beeb/nts-player/docs/README.md

# Datasheets

| Part | Use | Document |
| --- | --- | --- |
| PCM5122 | DAC | [TI SLAS763](https://www.ti.com/lit/ds/symlink/pcm5122.pdf) |
| TPS22918 | LED ring power | [TI SLVSD76](https://www.ti.com/lit/ds/symlink/tps22918.pdf) |
| SN74AHCT1G125 | LED level shifter | [TI SCLS378](https://www.ti.com/lit/ds/symlink/sn74ahct1g125.pdf) |
| LM66100 | Ideal diode | [TI SLVSEZ8](https://www.ti.com/lit/ds/symlink/lm66100.pdf) |
| PEC11R-4120F-S0018 | Encoder | [Bourns PEC11R](https://www.bourns.com/docs/product-datasheets/pec11r.pdf) |
| RCJ-2123 | RCA jack | [Same Sky RCJ-21](https://www.sameskydevices.com/product/resource/rcj-21.pdf) |
| SJ1-3523N | 3.5 mm jack | [Same Sky SJ1-352XN](https://www.sameskydevices.com/product/resource/sj1-352xn.pdf) |
| ESP32-S3-DEV-KIT-N8R8 | Devkit | [Waveshare wiki](https://www.waveshare.com/wiki/ESP32-S3-DEV-KIT-N8R8) |
| ESP32-S3-DEV-KIT-N8R8 | Devkit schematic  | [Waveshare schematic](https://files.waveshare.com/wiki/ESP32-S3-DEV-KIT-N8R8/ESP32-S3-DEV-KIT-N8R8-schematic.pdf) |
| Adafruit PCM5122 | Reference design  | [Adafruit downloads](https://learn.adafruit.com/adafruit-pcm5122-i2s-dac/downloads) |

## Devkit Pinout

[`esp32-s3-dev-kit-pinout.pdf`](./esp32-s3-dev-kit-pinout.pdf): "ESP32-S3-DEV-KIT-NxR8 Pinout", Rev. 0.1, by Vishnu
Mohanan, [CIRCUITSTATE Electronics](https://www.circuitstate.com/). It is licensed under
[CC BY 4.0](https://creativecommons.org/licenses/by/4.0/) and is not modified. The licenses of this repository do not
apply to it.
