beeb/nts-player/enclosure/logos.step

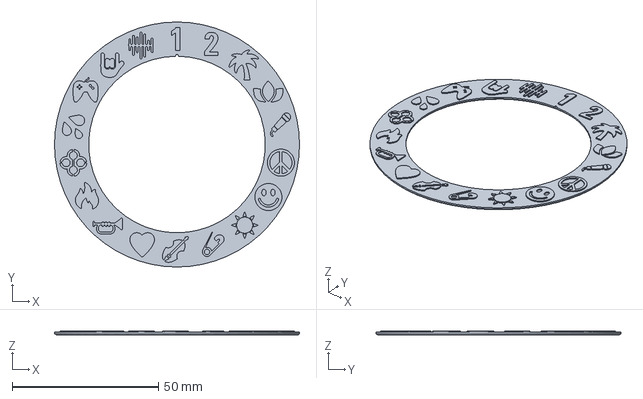
[picture p1: CAD file, 2026-11-12]
enclosure/logos.step
83.7 x 83.7 x 1.36 mm
