beeb/nts-player/enclosure/top_case.step

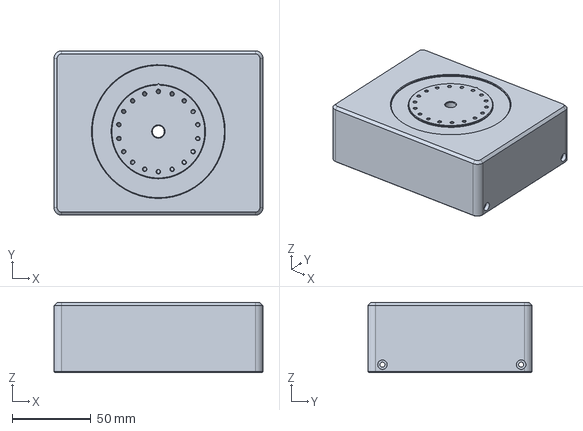
[picture p2: CAD file, 2026-11-12]
enclosure/top_case.step
132.8 x 104.4 x 44.5 mm
