beeb/nts-player/enclosure/bottom_case.step

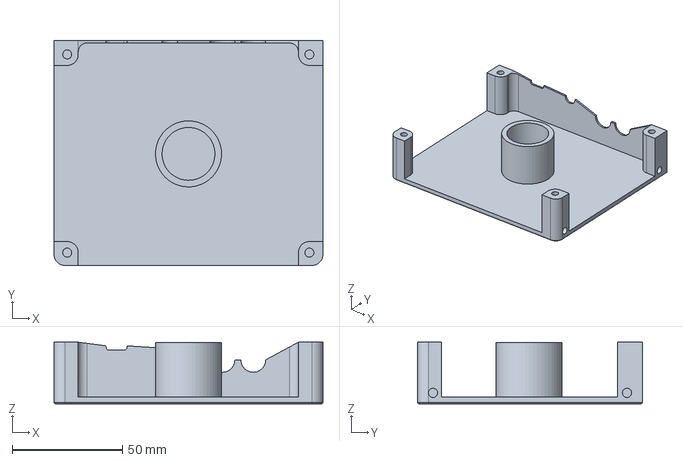
[picture p3: CAD file, 2026-11-12]
enclosure/bottom_case.step
122.2 x 102.1 x 28.0 mm
