beeb/nts-player/(list of files, cad)

Other CAD files:
enclosure/bottom_case.stl
enclosure/logos.stl
enclosure/top_case.stl
