beeb/nts-player/kicad/nts_player/nts_player.kicad_pcb

## KiCad design kicad/nts_player/nts_player.kicad_pcb (2026-10-24)

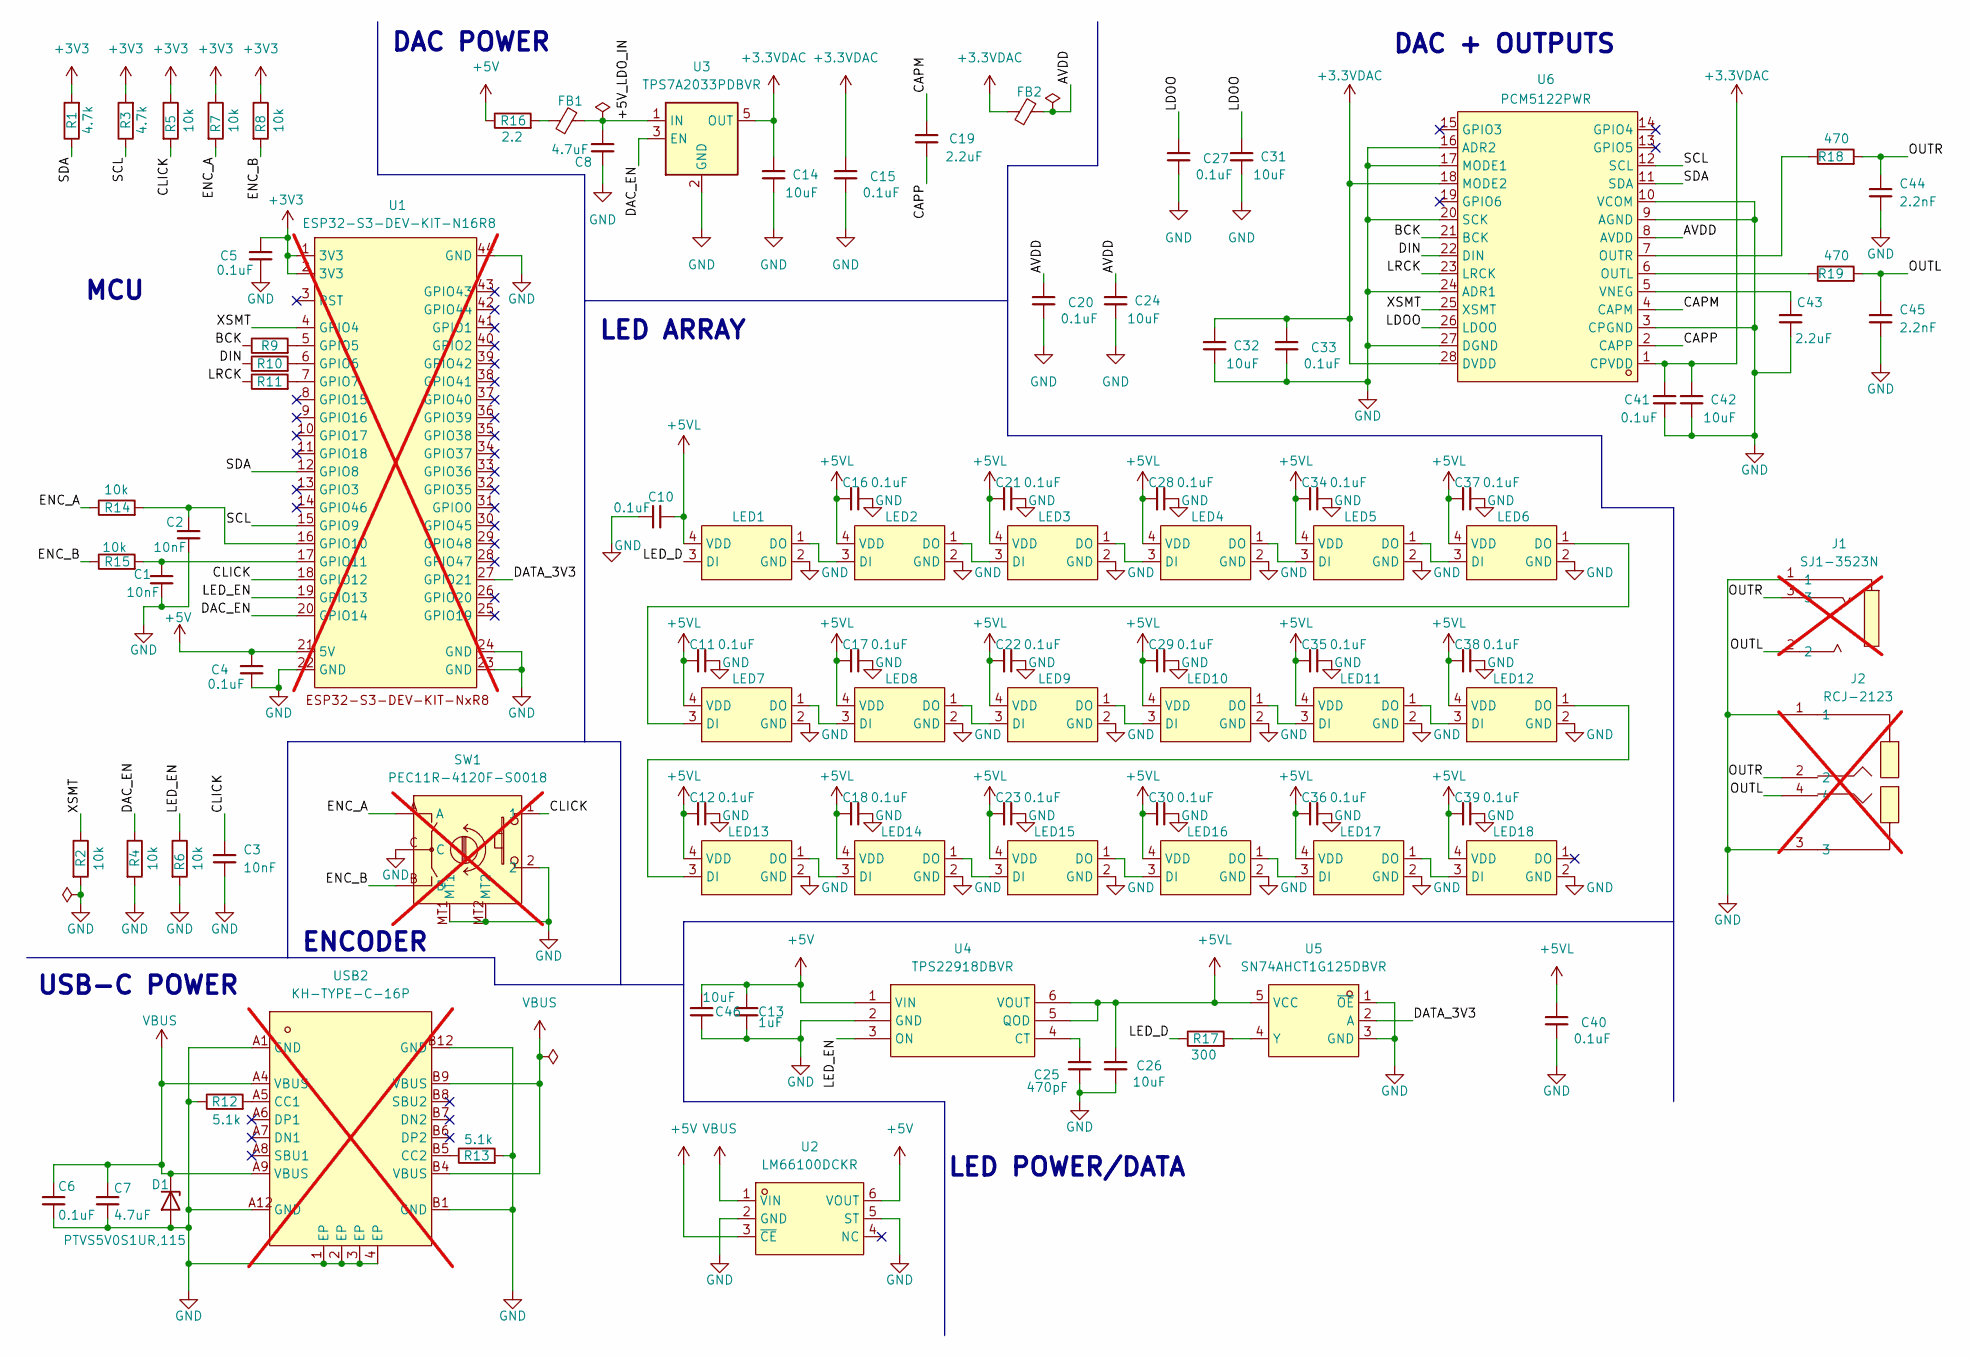
[picture p4: schematic nts_player.kicad_sch, NTS Player]

Parts:
C1, C2, C3: 10nF; C0603; MPN 0603B103K500NT; LCSC Part C57112
C4, C5, C6, C10, C11, C12, C15, C16, C17, C18, C20, C21, C22, C23, C27, C28, C29, C30, C33, C34, C35, C36, C37, C38, C39, C40, C41: 0.1uF; C0603; MPN CC0603KRX7R9BB104; LCSC Part C14663
C7, C8: 4.7uF; C0603; MPN CL10A475KO8NNNC; LCSC Part C19666
C13: 1uF; C0603; MPN CL10A105KB8NNNC; LCSC Part C15849
C14, C24, C26, C31, C32, C42, C46: 10uF; C1206; MPN CL31A106KBHNNNE; LCSC Part C13585
C19, C43: 2.2uF; C1206; MPN CL31B225KBHNNNE; LCSC Part C50254
C25: 470pF; C0805; MPN 0805B471K500NT; LCSC Part C1743
C44, C45: 2.2nF; C0805; MPN CL21C222JBFNNNE; LCSC Part C28260
D1: PTVS5V0S1UR,115; SOD-123_L2.8-W1.8-LS3.7-RD; MPN PTVS5V0S1UR,115; LCSC Part C478011
FB1, FB2: GZ1608D601TF; L0603; MPN GZ1608D601TF; LCSC Part C1002
J1: SJ1-3523N; AUDIO-TH_SJ1-3523N; MPN SJ1-3523N; LCSC Part C20182914; not fitted
J2: RCJ-2123; CONN-TH_RCJ-2123; MPN RCJ-2123; LCSC Part C4991847; not fitted
LED1, LED2, LED3, LED4, LED5, LED6, LED7, LED8, LED9, LED10, LED11, LED12, LED13, LED14, LED15, LED16, LED17, LED18: WS2812B-2020-V6; WS2815B-2020-V6; MPN WS2812B-2020-V6; LCSC Part C52917434
R1, R3: 4.7k; R0603; MPN 0603WAF4701T5E; LCSC Part C23162
R2, R4, R5, R6, R7, R8, R14, R15: 10k; R0603; MPN 0603WAF1002T5E; LCSC Part C25804
R9, R10, R11: 33; R0603; MPN 0603WAF330JT5E; LCSC Part C23140
R12, R13: 5.1k; R0603; MPN 0603WAF5101T5E; LCSC Part C23186
R16: 2.2; R0603; MPN 0603WAF220KT5E; LCSC Part C22939
R17: 300; R0603; MPN 0603WAF3000T5E; LCSC Part C23025
R18, R19: 470; R0805; MPN 0805W8F4700T5E; LCSC Part C17710
SW1: PEC11R-4120F-S0018; SW-TH_PEC11R-4XXXF-SXXXX; MPN PEC11R-4120F-S0018; LCSC Part C22402546; not fitted
U1: ESP32-S3-DEV-KIT-N16R8; ESP32-S3-DEV-KIT-NXR8; not fitted
U2: LM66100DCKR; SC-70-6_L2.0-W1.3-P0.65-LS2.1-BL; MPN LM66100DCKR; LCSC Part C2869734
U3: TPS7A2033PDBVR; SOT-23-5; MPN TPS7A2033PDBVR; LCSC Part C2862740
U4: TPS22918DBVR; SOT-23-6_L2.9-W1.6-P0.95-LS2.8-BR; MPN TPS22918DBVR; LCSC Part C131941
U5: SN74AHCT1G125DBVR; SOT-23-5_L3.0-W1.7-P0.95-LS2.8-BR; MPN SN74AHCT1G125DBVR; LCSC Part C7484
U6: PCM5122PWR; TSSOP-28_L9.8-W6.6-P0.65-BL; MPN PCM5122PWR; LCSC Part C962071
USB2: KH-TYPE-C-16P; USB-C-SMD_KH-TYPE-C-16P; MPN KH-TYPE-C-16P; LCSC Part C709357; not fitted

Connections:
+3.3VDAC: C14.2, C15.2, C32.2, C33.2, C41.2, C42.2, FB2.1, U3.5 (OUT), U6.1 (CPVDD), U6.18 (MODE2), U6.28 (DVDD)
+3V3: C5.2, R1.2, R3.2, R5.1, R7.1, R8.1, U1.1 (3V3), U1.2 (3V3)
+5V: C4.2, C13.1, C46.2, R16.1, U1.21 (5V), U2.3 (~CE), U2.6 (VOUT), U4.1 (VIN)
+5VL: C10.1, C11.2, C12.2, C16.2, C17.2, C18.2, C21.2, C22.2, C23.2, C26.2, C28.2, C29.2, C30.2, C34.2, C35.2, C36.2, C37.2, C38.2, C39.2, C40.2, LED1.4 (VDD), LED2.4 (VDD), LED3.4 (VDD), LED4.4 (VDD), LED5.4 (VDD), LED6.4 (VDD), LED7.4 (VDD), LED8.4 (VDD), LED9.4 (VDD), LED10.4 (VDD), LED11.4 (VDD), LED12.4 (VDD), LED13.4 (VDD), LED14.4 (VDD), LED15.4 (VDD), LED16.4 (VDD), LED17.4 (VDD), LED18.4 (VDD), U4.5 (QOD), U4.6 (VOUT), U5.5 (VCC)
/+5V_LDO_IN: C8.1, FB1.2, U3.1 (IN)
/AVDD: C20.2, C24.2, FB2.2, U6.8 (AVDD)
/BCK: R9.1, U6.21 (BCK)
/CAPM: C19.1, U6.4 (CAPM)
/CAPP: C19.2, U6.2 (CAPP)
/CLICK: C3.1, R5.2, SW1.1, U1.18 (GPIO12)
/DAC_EN: R4.1, U1.20 (GPIO14), U3.3 (EN)
/DATA_3V3: U1.27 (GPIO21), U5.2 (A)
/DIN: R10.1, U6.22 (DIN)
/ENC_A: R7.2, R14.1, SW1.A
/ENC_B: R8.2, R15.1, SW1.B
/LDOO: C27.2, C31.2, U6.26 (LDOO)
/LED_D: LED1.3 (DI), R17.1
/LED_EN: R6.1, U1.19 (GPIO13), U4.3 (ON)
/LRCK: R11.1, U6.23 (LRCK)
/OUTL: C45.1, J1.2, J2.4, R19.2
/OUTR: C44.1, J1.3, J2.2, R18.2
/SCL: R3.1, U1.15 (GPIO9), U6.12 (SCL)
/SDA: R1.1, U1.12 (GPIO8), U6.11 (SDA)
/XSMT: R2.1, U1.4 (GPIO4), U6.25 (XSMT)
GND: C1.2, C2.2, C3.2, C4.1, C5.1, C6.1, C7.2, C8.2, C10.2, C11.1, C12.1, C13.2, C14.1, C15.1, C16.1, C17.1, C18.1, C20.1, C21.1, C22.1, C23.1, C24.1, C25.2, C26.1, C27.1, C28.1, C29.1, C30.1, C31.1, C32.1, C33.1, C34.1, C35.1, C36.1, C37.1, C38.1, C39.1, C40.1, C41.1, C42.1, C43.2, C44.2, C45.2, C46.1, D1.2 (A), J1.1, J2.1, J2.3, LED1.2 (GND), LED2.2 (GND), LED3.2 (GND), LED4.2 (GND), LED5.2 (GND), LED6.2 (GND), LED7.2 (GND), LED8.2 (GND), LED9.2 (GND), LED10.2 (GND), LED11.2 (GND), LED12.2 (GND), LED13.2 (GND), LED14.2 (GND), LED15.2 (GND), LED16.2 (GND), LED17.2 (GND), LED18.2 (GND), R2.2, R4.2, R6.2, R12.1, R13.2, SW1.2, SW1.C, SW1.MT1, SW1.MT2, U1.22 (GND), U1.23 (GND), U1.24 (GND), U1.44 (GND), U2.2 (GND), U2.5 (ST), U3.2 (GND), U4.2 (GND), U5.1 (~OE), U5.3 (GND), U6.3 (CPGND), U6.9 (AGND), U6.10 (VCOM), U6.16 (ADR2), U6.17 (MODE1), U6.20 (SCK), U6.24 (ADR1), U6.27 (DGND), USB2.1 (EP), USB2.2 (EP), USB2.3 (EP), USB2.4 (EP), USB2.A1 (GND), USB2.A12 (GND), USB2.B1 (GND), USB2.B12 (GND); also elsewhere on the board
unnamed: FB1.1, R16.2
unnamed: LED1.1 (DO), LED2.3 (DI)
unnamed: LED2.1 (DO), LED3.3 (DI)
unnamed: LED3.1 (DO), LED4.3 (DI)
unnamed: LED4.1 (DO), LED5.3 (DI)
unnamed: LED5.1 (DO), LED6.3 (DI)
unnamed: LED6.1 (DO), LED7.3 (DI)
unnamed: LED7.1 (DO), LED8.3 (DI)
unnamed: LED8.1 (DO), LED9.3 (DI)
unnamed: LED9.1 (DO), LED10.3 (DI)
unnamed: LED10.1 (DO), LED11.3 (DI)
unnamed: LED11.1 (DO), LED12.3 (DI)
unnamed: LED12.1 (DO), LED13.3 (DI)
unnamed: LED13.1 (DO), LED14.3 (DI)
unnamed: LED14.1 (DO), LED15.3 (DI)
unnamed: LED15.1 (DO), LED16.3 (DI)
unnamed: LED16.1 (DO), LED17.3 (DI)
unnamed: LED17.1 (DO), LED18.3 (DI)
unnamed: R9.2, U1.5 (GPIO5)
unnamed: R10.2, U1.6 (GPIO6)
unnamed: R11.2, U1.7 (GPIO7)
unnamed: C2.1, R14.2, U1.16 (GPIO10)
unnamed: C1.1, R15.2, U1.17 (GPIO11)
unnamed: C25.1, U4.4 (CT)
unnamed: R17.2, U5.4 (Y)
unnamed: R19.1, U6.6 (OUTL)
unnamed: R18.1, U6.7 (OUTR)
unnamed: C43.1, U6.5 (VNEG)
unnamed: R12.2, USB2.A5 (CC1)
unnamed: R13.1, USB2.B5 (CC2)
VBUS: C6.2, C7.1, D1.1 (K), U2.1 (VIN), USB2.A4 (VBUS), USB2.A9 (VBUS), USB2.B4 (VBUS), USB2.B9 (VBUS)

Notes on the sheet:
ENCODER
DAC POWER
LED POWER/DATA
MCU
DAC + OUTPUTS
USB-C POWER
LED ARRAY

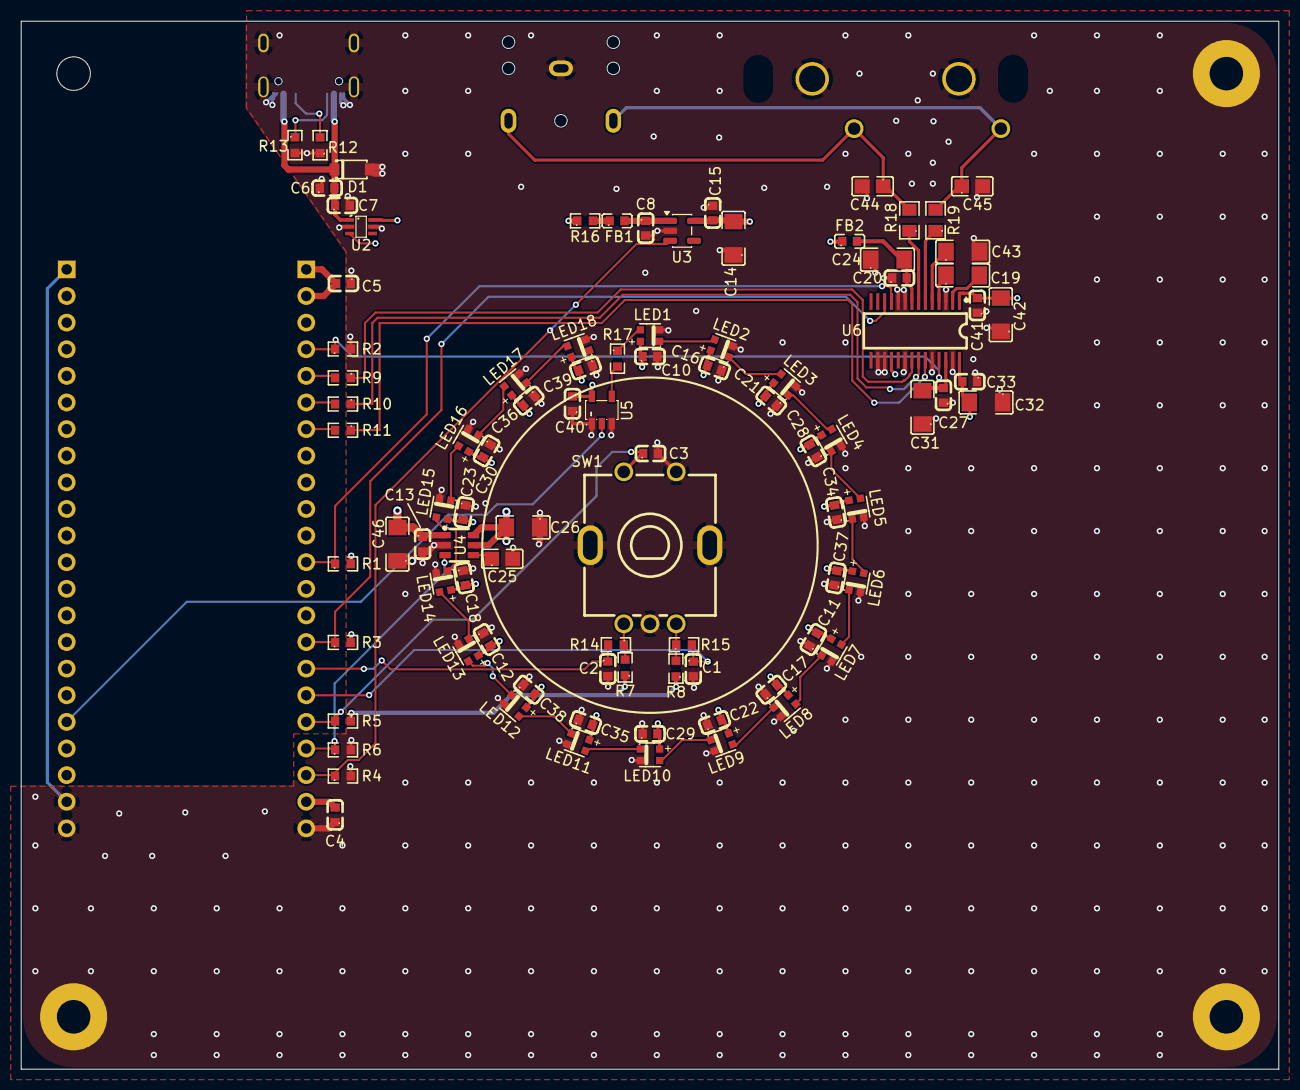
[picture p5: board nts_player.kicad_pcb from above]

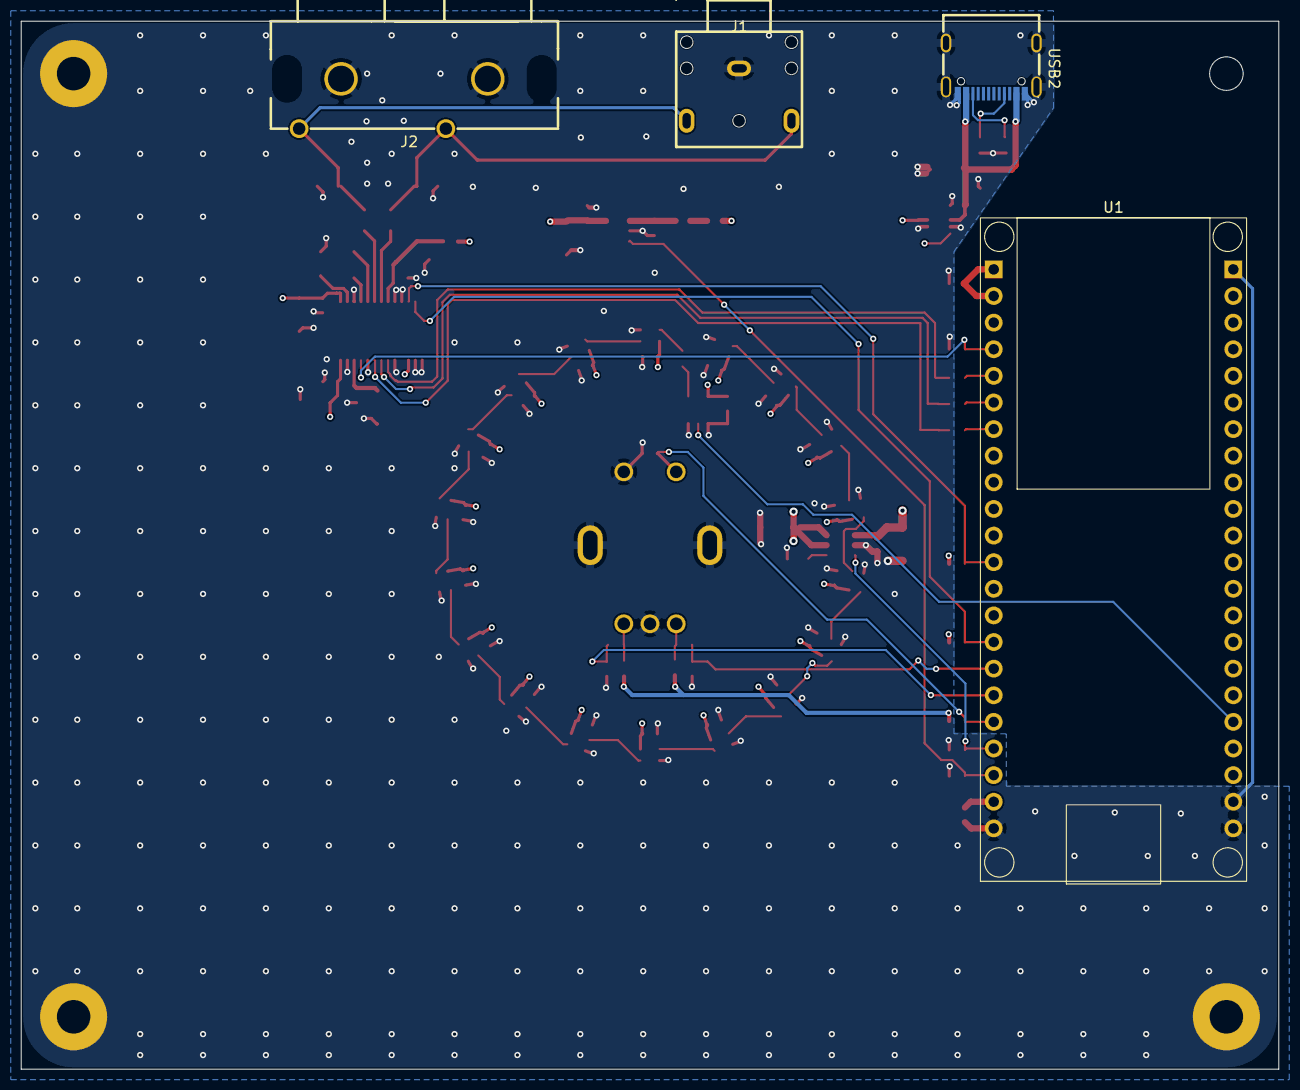
[picture p6: board nts_player.kicad_pcb from below]

Board: 4 copper layers, 120.0 x 100.0 mm, 99 parts (4 on the bottom side), 56 nets.

Other parts of the board:
H1: MountingHole_3.2mm_M3
H2, H3, H4: MountingHole_3.2mm_M3_Pad

Their connections:
GND: H2.1, H3.1, H4.1; also elsewhere on the board
