beeb/nts-player/firmware/src/main.rs

use std::{
    sync::{Arc, Mutex, mpsc},
    thread,
    time::Duration,
};

use anyhow::Result;
use esp_idf_svc::{
    eventloop::EspSystemEventLoop,
    hal::{peripherals::Peripherals, reset::restart},
    nvs::EspDefaultNvsPartition,
    wifi::{BlockingWifi, EspWifi},
};

use crate::{
    api::{Api, Snapshot},
    audio::Player,
    buffer::RingBuffer,
    dac::{Dac, DacPins, I2sPins},
    input::{InputPins, Ui},
    led::{Color, Led, Ring},
    ota::Ota,
    settings::Settings,
    status::{State, Status},
    stream::{Stream, Tuner},
    wifi::Credentials,
};

mod api;
mod audio;
mod buffer;
mod dac;
mod input;
mod led;
mod ota;
mod portal;
mod prelude;
mod settings;
mod status;
mod stream;
mod wifi;

/// Name and version in the image header, the update page checks them.
#[expect(unexpected_cfgs)]
mod app_desc {
    esp_idf_svc::sys::esp_app_desc!();
}

const CONNECT_ATTEMPTS: usize = 3;
const PORTAL_TIMEOUT: Duration = Duration::from_mins(5);
const WIFI_CHECK_INTERVAL: Duration = Duration::from_secs(5);

/// About 5 s of audio at 256 kbps.
const BUFFER_SIZE: usize = 160 * 1024;

fn main() {
    // It is necessary to call this function once. Otherwise, some patches to the runtime
    // implemented by esp-idf-sys might not link properly. See https://github.com/esp-rs/esp-idf-template/issues/71
    esp_idf_svc::sys::link_patches();

    // Bind the log crate to the ESP Logging facilities
    esp_idf_svc::log::EspLogger::initialize_default();

    let mut led = None;
    let status = Arc::new(Status::default());
    if let Err(e) = run(&mut led, &status) {
        log::error!("{e:?}");
        status.set(State::Fatal);
        if let Some(led) = &led {
            led.set(Color::DBG_RED).ok();
        }
        thread::sleep(Duration::from_secs(5));
        restart();
    }
}

/// Run the app, storing the LED in `led` so that `main` can still use it on error.
#[expect(
    clippy::too_many_lines,
    reason = "the startup sequence reads best in one place"
)]
fn run(led: &mut Option<Arc<Led>>, status: &Arc<Status>) -> Result<()> {
    let peripherals = Peripherals::take()?;
    let led = led.insert(Arc::new(Led::new(peripherals.pins.gpio38)?));
    let nvs = EspDefaultNvsPartition::take()?;
    let settings = Settings::load(nvs.clone())?;
    let tuner = Arc::new(Tuner::new(settings.station));
    let buffer = Arc::new(RingBuffer::new(BUFFER_SIZE));
    let dac = Arc::new(Dac::new(
        DacPins {
            en: peripherals.pins.gpio14.degrade_output(),
            xsmt: peripherals.pins.gpio4.degrade_output(),
            i2c: peripherals.i2c0,
            sda: peripherals.pins.gpio8.degrade_input_output(),
            scl: peripherals.pins.gpio9.degrade_input_output(),
            i2s: I2sPins {
                i2s: peripherals.i2s0,
                bck: peripherals.pins.gpio5.degrade_input_output(),
                din: peripherals.pins.gpio6.degrade_output(),
                lrck: peripherals.pins.gpio7.degrade_input_output(),
            },
        },
        settings.volume,
    )?);
    let snapshot = Arc::new(Mutex::new(Snapshot::new(settings)));
    let (commands_tx, commands_rx) = mpsc::channel();
    Ui::spawn(
        InputPins {
            enc_a: peripherals.pins.gpio10.degrade_input(),
            enc_b: peripherals.pins.gpio11.degrade_input(),
            push: peripherals.pins.gpio12.degrade_input(),
            boot: peripherals.pins.gpio0.degrade_input(),
        },
        led.clone(),
        Ring::new(peripherals.pins.gpio21, peripherals.pins.gpio13)?,
        tuner.clone(),
        buffer.clone(),
        dac.clone(),
        status.clone(),
        settings,
        snapshot.clone(),
        commands_rx,
        nvs.clone(),
    )?;
    let sysloop = EspSystemEventLoop::take()?;
    let mut wifi = BlockingWifi::wrap(
        EspWifi::new(peripherals.modem, sysloop.clone(), Some(nvs.clone()))?,
        sysloop,
    )?;

    let Some(mut creds) = Credentials::load(nvs.clone())? else {
        log::info!("no wifi credentials saved");
        led.set(Color::DBG_BLUE)?;
        status.set(State::Portal);
        return portal::run(wifi, nvs, None); // stay on portal forever
    };
    led.set(Color::DBG_YELLOW)?;
    let connected = (1..=CONNECT_ATTEMPTS).any(|attempt| {
        creds
            .connect(&mut wifi)
            .inspect_err(|e| {
                log::warn!(
                    "connection attempt {attempt} to {} failed: {e:?}",
                    creds.ssid
                );
            })
            .is_ok()
    });
    if !connected {
        // connecting with saved credentials failed, let's show the portal
        // again for a little bit before we retry
        led.set(Color::DBG_BLUE)?;
        status.set(State::Portal);
        return portal::run(wifi, nvs, Some(PORTAL_TIMEOUT));
    }
    led.set(Color::DBG_GREEN)?;
    status.set(State::Online);
    log::info!(
        "connected to {}, ip: {}",
        creds.ssid,
        wifi.wifi().sta_netif().get_ip_info()?.ip
    );
    if let Err(e) = creds.save_channel(nvs.clone(), &wifi) {
        log::warn!("could not save wifi channel: {e:?}");
    }

    Stream::spawn(tuner, buffer.clone(), status.clone(), nvs)?;
    Player::spawn(buffer, dac)?;
    if let Err(e) = Api::spawn(wifi.wifi().sta_netif(), snapshot, commands_tx.clone()) {
        log::warn!("could not start the API, playing anyway: {e:?}");
    }
    // keep the server alive in the loop below
    let _ota = Ota::start(commands_tx)
        .inspect_err(|e| log::warn!("could not start the update page, playing anyway: {e:?}"));
    // keep `wifi` alive and reconnect it when the link drops
    loop {
        thread::sleep(WIFI_CHECK_INTERVAL);
        if wifi.is_connected()? {
            continue;
        }
        log::warn!("wifi down, reconnecting");
        status.set(State::Connecting);
        if let Err(e) = creds.connect(&mut wifi) {
            log::warn!("wifi reconnect failed: {e:?}");
            // the router may have moved to another channel
            creds.channel = None;
        } else {
            log::info!("wifi reconnected");
            status.set(State::Online);
        }
    }
}
