beeb/nts-player/firmware/src/input.rs

use std::{
    sync::Arc,
    thread,
    time::{Duration, Instant},
};

use anyhow::Result;
use esp_idf_svc::{
    hal::{
        delay::FreeRtos,
        gpio::{AnyInputPin, Input, Pin, PinDriver, Pull},
        pcnt::{
            PcntUnitDriver,
            config::{
                ChannelConfig, ChannelEdgeAction, ChannelLevelAction, GlitchFilterConfig,
                UnitConfig,
            },
        },
        reset::restart,
    },
    nvs::EspDefaultNvsPartition,
    sys::{
        esp, esp_deep_sleep_start, esp_sleep_enable_ext0_wakeup, esp_wifi_stop, nvs_flash_erase,
        rtc_gpio_pullup_en,
    },
};

use crate::{
    buffer::RingBuffer,
    dac::Dac,
    led::{Color, Led, RING_LEDS, Ring},
    settings::{Settings, Volume},
    status::{State, Status},
    stream::{STATION_COUNT, Tuner},
};

/// Stack size of the input thread, NVS writes need more than the 4 KB default.
const STACK_SIZE: usize = 8 * 1024;

/// Hold time for putting the device to sleep.
const LONG_PRESS: Duration = Duration::from_millis(700);

/// Hold time of the boot button for erasing NVS and restarting.
const RESET_PRESS: Duration = Duration::from_secs(5);

/// Color of the onboard LED blink while the boot button is held, then solid once NVS is erased.
const RESET_WARNING: Color = Color::DBG_RED;

/// Time after the last step before a change is applied and saved.
const SETTLE: Duration = Duration::from_millis(400);

/// Go back from volume to station mode automatically after this duration without input.
const VOLUME_TIMEOUT: Duration = Duration::from_secs(5);

/// Time without input before dimming the ring.
const IDLE_TIMEOUT: Duration = Duration::from_secs(10);

/// Ring level when idle, from 0 to 1.
const IDLE_LEVEL: f32 = 0.4;

/// Number of [`POLL_DELAY_MS`] duration ticks for the ring fade before sleep.
const FADE_TICKS: u16 = 30;

/// Polling interval for the inputs, in milliseconds.
const POLL_DELAY_MS: u32 = 10;

/// Quadrature edges per encoder detent (18 pulses and 18 detents per turn).
const EDGES_PER_DETENT: i32 = 4;

/// Glitch filter for the encoder signals, at most 12.7 us on the ESP32-S3.
const ENCODER_GLITCH: Duration = Duration::from_micros(10);

/// Number of [`POLL_DELAY_MS`] duration ticks for the switch debounce.
const DEBOUNCE_TICKS: u32 = 3;

/// Period of the station LED pulse while buffering.
const PULSE_PERIOD: Duration = Duration::from_millis(1500);

/// Period of the ring pulse while the setup portal runs.
const PORTAL_PERIOD: Duration = Duration::from_secs(3);

/// Lowest pulse level, as a fraction of the full color.
const PULSE_MIN: f32 = 0.2;

/// Period of the blink on a fatal error or a stream failure.
const BLINK_PERIOD: Duration = Duration::from_secs(1);

/// Duration of the spinning animation while connecting to wifi.
const SPIN_PERIOD: Duration = Duration::from_secs(1);

/// The input pins, all active low.
pub struct InputPins {
    /// Encoder channel A.
    pub enc_a: AnyInputPin<'static>,

    /// Encoder channel B.
    pub enc_b: AnyInputPin<'static>,

    /// Push button for mode switch and deep sleep/wake up.
    pub push: AnyInputPin<'static>,

    /// Boot button of the devkit, long-press to erase NVS and restart.
    pub boot: AnyInputPin<'static>,
}

/// The input and UI thread state.
pub struct Ui {
    encoder: Encoder,
    push: Switch,
    boot: Switch,
    led: Arc<Led>,
    ring: Ring,
    tuner: Arc<Tuner>,
    buffer: Arc<RingBuffer>,
    dac: Arc<Dac>,
    status: Arc<Status>,
    nvs: EspDefaultNvsPartition,
    settings: Settings,
    mode: Mode,
    /// The scene during the last draw.
    scene: Scene,
    /// Start of the current scene, for its animation.
    scene_start: Instant,
    /// Start of the current push.
    ///
    /// The first push (waking up the device) does not count, so it's still `None`. Also `None` when the button is
    /// not pressed.
    pushed_at: Option<Instant>,
    /// Start of the current boot button press.
    boot_pushed_at: Option<Instant>,
    /// Time of the last station or volume change that is not applied yet.
    changed_at: Option<Instant>,
    /// Time of the last input (press or turn).
    input_at: Instant,
    /// Scale of the ring level during the fade before sleep, from 0 to 1.
    fade: f32,
}

impl Ui {
    /// Start the input thread.
    #[expect(
        clippy::too_many_arguments,
        reason = "each argument is a distinct shared handle"
    )]
    pub fn spawn(
        pins: InputPins,
        led: Arc<Led>,
        ring: Ring,
        tuner: Arc<Tuner>,
        buffer: Arc<RingBuffer>,
        dac: Arc<Dac>,
        status: Arc<Status>,
        settings: Settings,
        nvs: EspDefaultNvsPartition,
    ) -> Result<()> {
        let ui = Self {
            encoder: Encoder::new(pins.enc_a, pins.enc_b)?,
            push: Switch::new(pins.push)?,
            boot: Switch::new(pins.boot)?,
            led,
            ring,
            tuner,
            buffer,
            dac,
            status,
            nvs,
            settings,
            mode: Mode::Station,
            scene: Scene::Station,
            scene_start: Instant::now(),
            pushed_at: None,
            boot_pushed_at: None,
            changed_at: None,
            input_at: Instant::now(),
            fade: 1.0,
        };
        thread::Builder::new()
            .stack_size(STACK_SIZE)
            .spawn(move || {
                if let Err(e) = ui.run() {
                    log::error!("input thread: {e:?}");
                }
            })?;
        Ok(())
    }

    fn run(mut self) -> Result<()> {
        loop {
            FreeRtos::delay_ms(POLL_DELAY_MS);
            if let Some(step) = self.encoder.poll()? {
                self.step(step);
            }
            let push = self.push.poll();
            if push.is_some() {
                self.input_at = Instant::now();
            }
            match push {
                Some(true) => self.pushed_at = Some(Instant::now()),
                // only handle the change if we have a `pushed_at` and clear the timer
                Some(false) if self.pushed_at.take().is_some() => {
                    self.mode = self.mode.toggle();
                    log::info!("mode: {:?}", self.mode);
                }
                _ => {}
            }
            if matches!(self.mode, Mode::Volume) && self.input_at.elapsed() >= VOLUME_TIMEOUT {
                // switch back to station mode after inactivity
                self.mode = Mode::Station;
                log::info!("mode: {:?} (timeout)", self.mode);
            }
            if self.pushed_at.is_some_and(|t| t.elapsed() >= LONG_PRESS) {
                return self.sleep();
            }
            if let Some(pressed) = self.boot.poll() {
                self.boot_pushed_at = pressed.then(Instant::now);
                if !pressed && let Err(e) = self.led.restore() {
                    log::warn!("could not restore the LED: {e:?}");
                }
            }
            if let Some(t) = self.boot_pushed_at.map(|t| t.elapsed()) {
                if t >= RESET_PRESS {
                    return self.reset();
                }
                // warn that holding longer erases everything
                let color = if blink(t) { RESET_WARNING } else { Color::OFF };
                if let Err(e) = self.led.show(color) {
                    log::warn!("could not update the LED: {e:?}");
                }
            }
            if self.changed_at.is_some_and(|t| t.elapsed() >= SETTLE) {
                self.changed_at = None;
                self.commit();
            }
            self.draw();
        }
    }

    /// Move the pending station or the volume by one step.
    fn step(&mut self, step: Step) {
        let s = &mut self.settings;
        match self.mode {
            Mode::Station => {
                let n = STATION_COUNT;
                s.station = match step {
                    Step::Left => s.station.checked_sub(1).unwrap_or(n - 1),
                    Step::Right => (s.station + 1) % n,
                };
                log::info!("station {} (pending)", s.station);
            }
            Mode::Volume => {
                s.volume = match step {
                    Step::Left => s.volume.down(),
                    Step::Right => s.volume.up(),
                };
                log::info!("volume {}/{}", s.volume.get(), Volume::MAX.get());
                // the settle delay is only for saving
                if let Err(e) = self.dac.set_volume(s.volume) {
                    log::warn!("could not set the volume: {e:?}");
                }
            }
        }
        self.changed_at = Some(Instant::now());
        self.input_at = Instant::now();
    }

    /// Apply the pending station and save the settings.
    fn commit(&self) {
        if self.tuner.get() != self.settings.station {
            log::info!("tuning to station {}", self.settings.station);
            if let Err(e) = self.dac.mute() {
                log::warn!("could not mute: {e:?}");
            }
            self.buffer.clear();
            self.tuner.set(self.settings.station);
        }
        if let Err(e) = self.settings.save(self.nvs.clone()) {
            log::warn!("could not save settings: {e:?}");
        }
    }

    /// Draw the current scene on the ring.
    fn draw(&mut self) {
        let idle = self.input_at.elapsed() >= IDLE_TIMEOUT;
        let level = if idle { IDLE_LEVEL } else { 1.0 };
        self.ring.set_level(level * self.fade);
        let scene = self.scene();
        // restart the animation on each change
        if scene != self.scene {
            self.scene = scene;
            self.scene_start = Instant::now();
        }
        let t = self.scene_start.elapsed();
        let station = self.settings.station;
        let color = Color::station(station);
        let res = match scene {
            Scene::Fatal if blink(t) => self.ring.all(Color::ERROR),
            Scene::Fatal => self.ring.all(Color::OFF),
            Scene::Portal => self.ring.all(Color::WIFI.scale(wave(t, PORTAL_PERIOD))),
            Scene::Connecting => self.ring.dot(spin(t), Color::WIFI),
            Scene::Stalled if blink(t) => self.ring.dot(station, color),
            Scene::Stalled => self.ring.dot(station, Color::OFF),
            Scene::Buffering => self.ring.dot(station, color.scale(wave(t, PULSE_PERIOD))),
            Scene::Station => self.ring.dot(station, color),
            Scene::Volume => self.ring.volume(self.settings.volume),
        };
        if let Err(e) = res {
            log::warn!("could not update LED ring: {e:?}");
        }
    }

    fn scene(&self) -> Scene {
        match self.status.get() {
            State::Fatal => Scene::Fatal,
            State::Portal => Scene::Portal,
            State::Connecting => Scene::Connecting,
            State::Online => match self.mode {
                Mode::Station if self.status.is_stalled() => Scene::Stalled,
                Mode::Station if self.buffer.is_filling() => Scene::Buffering,
                Mode::Station => Scene::Station,
                Mode::Volume => Scene::Volume,
            },
        }
    }

    /// Turn everything off, wait for the button release and enter deep sleep.
    fn sleep(&mut self) -> Result<()> {
        log::info!("long press, going to sleep");
        self.dac.power_down()?;
        // turn the LEDs off to indicate the press was long enough
        self.led.set(Color::OFF)?;
        for tick in (0..FADE_TICKS).rev() {
            self.fade = f32::from(tick) / f32::from(FADE_TICKS);
            self.draw();
            FreeRtos::delay_ms(POLL_DELAY_MS);
        }
        self.ring.shutdown()?;
        while self.push.pin.is_low() {
            FreeRtos::delay_ms(POLL_DELAY_MS);
        }
        // a bounce at sleep start would wake the device right away
        FreeRtos::delay_ms(DEBOUNCE_TICKS * POLL_DELAY_MS);
        unsafe { esp_wifi_stop() };
        let pin = self.push.pin.pin().into();
        esp!(unsafe { rtc_gpio_pullup_en(pin) })?;
        esp!(unsafe { esp_sleep_enable_ext0_wakeup(pin, 0) })?;
        unsafe { esp_deep_sleep_start() }
    }

    /// Erase the whole NVS partition, wait for the boot button release and restart.
    fn reset(&mut self) -> Result<()> {
        log::warn!("boot button held, erasing NVS");
        self.ring.set_level(1.0);
        self.ring.all(Color::ERROR)?;
        self.led.show(RESET_WARNING)?;
        esp!(unsafe { nvs_flash_erase() })?;
        // the boot button is a strapping pin, don't restart while it's low
        while self.boot.pin.is_low() {
            FreeRtos::delay_ms(POLL_DELAY_MS);
        }
        restart();
    }
}

/// Encoder input mode.
#[derive(Clone, Copy, Debug)]
enum Mode {
    /// Change the station
    Station,

    /// Adjust the volume.
    Volume,
}

impl Mode {
    fn toggle(self) -> Self {
        match self {
            Self::Station => Self::Volume,
            Self::Volume => Self::Station,
        }
    }
}

/// What the ring shows.
#[derive(Clone, Copy, PartialEq, Eq)]
enum Scene {
    Fatal,
    Portal,
    Connecting,
    Stalled,
    Buffering,
    Station,
    Volume,
}

/// One encoder detent.
#[derive(Clone, Copy)]
enum Step {
    Left,
    Right,
}

/// A quadrature encoder decoded by the PCNT (pulse counter) peripheral.
///
/// Edges are counted in hardware to avoid losing steps between polls.
struct Encoder {
    unit: PcntUnitDriver<'static>,
    /// Count at the last emitted step.
    pos: i32,
}

impl Encoder {
    fn new(a: AnyInputPin<'static>, b: AnyInputPin<'static>) -> Result<Self> {
        let limit = i32::from(i16::MAX);
        let mut unit = PcntUnitDriver::new(&UnitConfig {
            low_limit: -limit,
            high_limit: limit,
            accum_count: true,
            ..Default::default()
        })?;
        unit.set_glitch_filter(Some(&GlitchFilterConfig {
            max_glitch: ENCODER_GLITCH,
            ..Default::default()
        }))?;
        // each pin is the edge input of one channel and the level input of the other
        let (a2, b2) = unsafe { (AnyInputPin::steal(a.pin()), AnyInputPin::steal(b.pin())) };
        unit.add_channel(Some(a), Some(b), &ChannelConfig::default())?
            .set_edge_action(ChannelEdgeAction::Decrease, ChannelEdgeAction::Increase)?
            .set_level_action(ChannelLevelAction::Keep, ChannelLevelAction::Inverse)?;
        unit.add_channel(Some(b2), Some(a2), &ChannelConfig::default())?
            .set_edge_action(ChannelEdgeAction::Increase, ChannelEdgeAction::Decrease)?
            .set_level_action(ChannelLevelAction::Keep, ChannelLevelAction::Inverse)?;
        unit.enable()?;
        unit.add_watch_points_and_clear([-limit, limit])?;
        unit.start()?;
        Ok(Self { unit, pos: 0 })
    }

    /// Read the counter.
    ///
    /// Returns one step once the count moved a full detent away from the last step.
    fn poll(&mut self) -> Result<Option<Step>> {
        let delta = self.unit.get_count()? - self.pos;
        if delta >= EDGES_PER_DETENT {
            self.pos += EDGES_PER_DETENT;
            Ok(Some(Step::Right))
        } else if delta <= -EDGES_PER_DETENT {
            self.pos -= EDGES_PER_DETENT;
            Ok(Some(Step::Left))
        } else {
            Ok(None)
        }
    }
}

/// A debounced active-low switch, sampled on each poll.
struct Switch {
    pin: PinDriver<'static, Input>,
    pressed: bool,
    /// Number of polls reading the opposite of `pressed`, used for debouncing.
    count: u32,
}

impl Switch {
    fn new(pin: AnyInputPin<'static>) -> Result<Self> {
        let pin = PinDriver::input(pin, Pull::Up)?;
        Ok(Self {
            pressed: pin.is_low(),
            pin,
            count: 0,
        })
    }

    /// Sample the pin.
    ///
    /// Returns the new state once a change exceeds the debounce time.
    fn poll(&mut self) -> Option<bool> {
        if self.pin.is_low() == self.pressed {
            self.count = 0;
            return None;
        }
        self.count = self.count.saturating_add(1);
        if self.count < DEBOUNCE_TICKS {
            return None;
        }
        self.count = 0;
        self.pressed = !self.pressed;
        Some(self.pressed)
    }
}

/// Pulse level for [`Color::scale`] at `t`, a triangle wave from 1 down to [`PULSE_MIN`] and back.
fn wave(t: Duration, period: Duration) -> f32 {
    let phase = (t.as_secs_f32() / period.as_secs_f32()).fract();
    // 0 at the middle of the period, 1 at both ends
    let tri = (phase - 0.5).abs() * 2.0;
    PULSE_MIN + tri * (1.0 - PULSE_MIN)
}

/// Whether the blink is on at `t`.
fn blink(t: Duration) -> bool {
    let period = BLINK_PERIOD.as_millis();
    t.as_millis() % period < period / 2
}

/// LED index of the spinning dot at `t`.
fn spin(t: Duration) -> u8 {
    let period = SPIN_PERIOD.as_millis();
    let i = t.as_millis() % period * u128::from(RING_LEDS) / period;
    u8::try_from(i).unwrap_or(0)
}
