beeb/nts-player/firmware/src/led.rs

use std::sync::Mutex;

use anyhow::Result;
use esp_idf_svc::hal::{
    delay::FreeRtos,
    gpio::{Output, OutputPin, PinDriver},
    rmt::config::{MemoryAccess, TxChannelConfig},
    units::Hertz,
};
use ws2812_esp32_rmt_driver::Ws2812Esp32RmtDriver;

use crate::{prelude::OrPanic, settings::Volume, stream::LIVE_STATIONS};

/// Time for the ring's power rail to rise before sending data, in milliseconds.
///
/// This is 2 ticks at 100 Hz, because a 1 tick delay can end right away.
const RAIL_RISE_MS: u32 = 20;

/// Number of LEDs on the ring.
pub const RING_LEDS: u8 = 18;

/// Index of the bottom LED, where the volume bar starts.
const VOLUME_START: u8 = RING_LEDS / 2;

/// Level of the bottom LED at volume 0, as a fraction of the volume color.
const VOLUME_ZERO: f32 = 0.5;

/// Byte value of a full color channel on the ring.
const BRIGHTNESS: f32 = 16.0;

/// Byte value of a full color channel on the onboard LED, which is very bright.
const DBG_BRIGHTNESS: f32 = 1.0;

/// Color of an RGB LED, with channels from 0 to 1.
#[derive(Clone, Copy)]
pub struct Color {
    pub r: f32,
    pub g: f32,
    pub b: f32,
}

impl Color {
    pub const OFF: Self = Self::rgb(0.0, 0.0, 0.0);
    pub const DBG_RED: Self = Self::rgb(1.0, 0.0, 0.0);
    pub const DBG_YELLOW: Self = Self::rgb(1.0, 1.0, 0.0);
    pub const DBG_GREEN: Self = Self::rgb(0.0, 1.0, 0.0);
    pub const DBG_BLUE: Self = Self::rgb(0.0, 0.0, 1.0);
    pub const LIVE: Self = Self::rgb(0.7, 0.7, 0.7);
    pub const MIXTAPE: Self = Self::rgb(1.0, 0.0, 0.0);
    pub const VOLUME: Self = Self::rgb(0.8, 0.41, 0.12);
    pub const WIFI: Self = Self::rgb(0.25, 0.0, 1.0);
    pub const ERROR: Self = Self::rgb(1.0, 0.0, 0.0);

    pub const fn rgb(r: f32, g: f32, b: f32) -> Self {
        Self { r, g, b }
    }

    /// Color of a station's LED, white for the live channels and red for the mixtapes.
    pub fn station(index: u8) -> Self {
        if index < LIVE_STATIONS {
            Self::LIVE
        } else {
            Self::MIXTAPE
        }
    }

    /// Scale the color by `level`, from 0 to 1.
    pub fn scale(self, level: f32) -> Self {
        Self::rgb(self.r * level, self.g * level, self.b * level)
    }

    /// Byte values of the channels, with `max` for a full channel.
    #[expect(
        clippy::cast_possible_truncation,
        clippy::cast_sign_loss,
        reason = "truncation is desirable to saturate the u8"
    )]
    fn bytes(self, max: f32) -> [u8; 3] {
        // round to nearest, flooring skews the hue at low levels
        let f = |c: f32| (c * max).round() as u8;
        [f(self.r), f(self.g), f(self.b)]
    }
}

/// A WS2812 RGB LED on a data pin.
pub struct Led(Mutex<LedState>);

impl Led {
    pub fn new(pin: impl OutputPin + 'static) -> Result<Self> {
        Ok(Self(Mutex::new(LedState {
            driver: Ws2812Esp32RmtDriver::new(pin)?,
            color: Color::OFF,
        })))
    }

    /// Set the color and remember it for [`Led::restore`].
    pub fn set(&self, color: Color) -> Result<()> {
        let mut state = self.0.lock().or_panic("LED mutex poisoned");
        state.color = color;
        state.write(color)
    }

    /// Show a temporary color, until the next [`Led::set`] or [`Led::restore`].
    pub fn show(&self, color: Color) -> Result<()> {
        self.0.lock().or_panic("LED mutex poisoned").write(color)
    }

    /// Show the last color given to [`Led::set`] again.
    pub fn restore(&self) -> Result<()> {
        let mut state = self.0.lock().or_panic("LED mutex poisoned");
        let color = state.color;
        state.write(color)
    }
}

struct LedState {
    driver: Ws2812Esp32RmtDriver<'static>,
    /// The last color given to [`Led::set`].
    color: Color,
}

impl LedState {
    fn write(&mut self, color: Color) -> Result<()> {
        // the onboard LED expects RGB order
        self.driver
            .write_blocking(color.bytes(DBG_BRIGHTNESS).into_iter())?;
        Ok(())
    }
}

/// The ring of WS2812 LEDs around the knob, with its power switch.
pub struct Ring {
    driver: Ws2812Esp32RmtDriver<'static>,
    power: PinDriver<'static, Output>,
    /// Scale of all colors, from 0 to 1.
    level: f32,
}

impl Ring {
    /// Power the ring on and turn all its LEDs off.
    pub fn new(data: impl OutputPin + 'static, power: impl OutputPin + 'static) -> Result<Self> {
        // a DMA buffer fits all pixels at once
        // esp-idf-hal 0.47 panics in the ISR when the RMT memory fills up mid-transfer
        let config = TxChannelConfig {
            resolution: Hertz(10_000_000),
            memory_access: MemoryAccess::Direct {
                memory_block_symbols: 1024,
            },
            ..Default::default()
        };
        // drive the data line low before powering the ring, a floating line makes the LEDs flash
        let driver = Ws2812Esp32RmtDriver::new_with_config(data, &config)?;
        let mut power = PinDriver::output(power)?;
        power.set_high()?;
        FreeRtos::delay_ms(RAIL_RISE_MS);
        let mut ring = Self {
            driver,
            power,
            level: 1.0,
        };
        ring.off()?;
        Ok(ring)
    }

    /// Light the LED at `index` only.
    pub fn dot(&mut self, index: u8, color: Color) -> Result<()> {
        self.write(color, |i| i == index)
    }

    /// Light all LEDs.
    pub fn all(&mut self, color: Color) -> Result<()> {
        self.write(color, |_| true)
    }

    /// Light a bar of `volume` LEDs clockwise from the bottom, or only a dim bottom LED at 0.
    pub fn volume(&mut self, volume: Volume) -> Result<()> {
        let volume = volume.get();
        // a dim marker shows that volume mode is on
        if volume == 0 {
            return self.dot(VOLUME_START, Color::VOLUME.scale(VOLUME_ZERO));
        }
        self.write(Color::VOLUME, |i| {
            (i + RING_LEDS - VOLUME_START) % RING_LEDS < volume
        })
    }

    /// Scale all following writes by `level`, from 0 to 1, to dim the whole ring.
    pub fn set_level(&mut self, level: f32) {
        self.level = level;
    }

    /// Turn all LEDs off and cut the ring power.
    pub fn shutdown(&mut self) -> Result<()> {
        self.off()?;
        self.power.set_low()?;
        Ok(())
    }

    fn off(&mut self) -> Result<()> {
        self.write(Color::OFF, |_| false)
    }

    /// Write `color` to the LEDs for which `lit` is true, and turn the others off.
    fn write(&mut self, color: Color, lit: impl Fn(u8) -> bool) -> Result<()> {
        // the ring expects GRB order
        let pixels = (0..RING_LEDS).flat_map(|i| {
            let c = if lit(i) {
                color.scale(self.level)
            } else {
                Color::OFF
            };
            let [r, g, b] = c.bytes(BRIGHTNESS);
            [g, r, b]
        });
        self.driver.write_blocking(pixels)?;
        Ok(())
    }
}
