beeb/nts-player/(commit log)

2026-10-12 feat: schematic
2026-10-17 feat: add footprint for esp32
2026-10-17 fix: footprints
2026-10-17 feat: create pcb
2026-10-17 fix: rca footprint
2026-10-19 feat: arrange LEDs
2026-10-19 feat: LED pour
2026-10-21 feat: work on pcb
2026-10-21 feat: finalize pcb
2026-10-23 feat: finish pcb
2026-10-24 fix: placement and change resistor
2026-10-24 feat: status LED for portal status
2026-10-25 feat: add deep sleep on button press
2026-10-28 feat: LED ring
2026-10-28 feat: pulse LEDs during buffering
2026-10-28 feat: detect and show stalled stream
2026-10-28 feat: switch back from volume to station mode after inactivity
2026-10-31 feat: LED fade
2026-10-31 feat: add DAC power and mute sequences
2026-10-31 refactor: add a Volume newtype based on the LED count
2026-11-03 feat: use encoder
2026-11-04 fix: left-align I2S samples in the 32-bit slot
2026-11-05 feat: reset settings with boot button
2026-11-06 fix: led flash after startup
2026-11-09 feat: add buttons for next and prev station in HA
2026-11-12 feat: add enclosure files
